yangdaniu8-ui/timing-sentinel-a7/report/llm_collaboration.md

# 大模型协作与技能提炼记录

## 真实性与范围

本文件区分可见对话的逐字节选和工程过程摘要，不补造模型回答或完整聊天导出。去除学校、姓名、账号、凭据和本机私人目录；不公开原会话链接。助手为Codex，具体历史模型子版本没有可靠逐轮记录，不猜测。以下新技能验证为离线操作，不新增实板资格。

## 逐字交互节选：发现漏项并纠正交付判断

**用户提示词：**

> skill准备了吗

**模型回答节选：**

> 有初稿，但还没完成交付，这项确实漏了。

> 刚核查，公开 GitHub 和最终源码 RAR 都没有包含 Skill。

这条回答来自实际目录、跟踪清单和RAR列表核查，不是根据此前385文件哈希通过而推断材料齐全。

**用户进一步要求：**

> Skill 的提交方式与评价标准见 3.3.5.2。从本队作品的开发过程中沉淀即可，但须写清它在本队
> 题目之外还能用在哪类场景，这是官方文档里面的，你仔细查查

**模型复核后的回答节选：**

> 现有初稿还不够，不能只把本项目操作说明改名为 Skill 就算完成。

> 官方没有要求必须安装到 Codex，也没有强制必须采用 `SKILL.md` 格式。

原指南第3.3.3.1、3.3.5.2、3.3.5.3分别约束随作品提交、可复用性与报告说明。复核还明确：通用PYNQ是另行加分，不应为此改变本项目器件；大模型协作与技能包共同15分，不是Skill独占15分。

**用户执行指令：**

> 好的，请你按照文档的详细要求，准备一下

**模型开始执行时的回答节选：**

> 我会按官方条款补齐可复用技能包、题目外示例和验证结果，并整理真实的大模型协作与纠错记录。

## 自我纠错链与人工判断

此前项目草稿绑定旧脚本及本机资料上下文，公开交付白名单没有技能目录。用户指出官方要求后，助手实际重读原文，纠正“有草稿即可交付”的判断：把专用协议和引脚留在案例，把通用检查改为显式文件列表及CSV接口；新增题目外正反例并验证，不把安装到助手当成比赛提交条件。代码包完整性检查仍保留，但补上独立的官方提交项矩阵。

本次第一次文件补丁因同一个README同时使用删除/新增操作而被工具拒绝，未执行任何部分文件写入；随后改成原位更新，保留旧项目专用草稿。这是编辑工具使用错误，不冒充硬件或验证失败。

新增链接拒绝测试两次在Windows失败：模拟按未归一化临时路径匹配，而校验器已resolve为长路径，导致模拟没有命中。第一次只改实际路径类型仍失败；再按规范化路径匹配后重跑，原失败日志保留。另一个真实链接创建测试因Windows权限不足显式skip，使用模拟验证拒绝分支但不声称真实链接用例已执行。技能格式检查器缺少PyYAML，临时依赖仅安装到检查目录，不修改应用环境，也不把依赖错误写成技能通过。

## 开发观察摘要（不是逐字模型原文）

| 真实过程 | 对模型建议的约束与纠正 | 沉淀内容 |
| --- | --- | --- |
| 资源优化候选仿真通过但实现出现BRAM相关DRC，被门禁拒绝 | 不仅追LUT，不从仿真通过推断可上板 | 分层验证与候选身份封存 |
| 串口上传失败后板端记录仍冻结，重连恢复同一记录 | 不把传输故障当采集失败，不盲目重刷 | 状态/身份核查及先保存后释放 |
| 原始记录已保存，旧程序包与新文档未总是同版 | 名称相同不能替代源码与附件核对 | 选定文件的SHA256清单 |
| 同事务四规则新增预设没有蜂鸣，原预设声光正常 | 识别正式RTL白名单限制，改为“仅波形”说明，不为收尾扩展固件 | 把已验证行为与预期区分，保留失败观察 |

这些历史摘要对应工程既有验证记录与当前公开`docs/verification.md`，不作为新脚本的测试次数。原声光问题没有改写成新增预设声光通过。

## 技能如何验证及如何复用

技能入口为`skill/README.md`，脚本使用Python标准库；计数器与四抽头全1系数FIR为两组明确合成夹具。测试检查同值不同CSV顺序仍通过、错值/缺失/篡改正确拒绝，且在仅复制脚本及计数器数据的新目录隔离运行。最终命令、环境、计数及输出哈希见`skill/fpga-evidence-check/validation_result.json`。

题目外可以用于其他RTL黄金结果比对、MCU/FPGA/PC联合交付。输出完整性和数字一致结论，不证明参考算法、综合、时序或实物正确；不宣称跨板实测或PYNQ通用Skill加分。此边界是防止把模型给出的“适用场景”误写为“已验证结果”。

## 工作流与人机分工

助手读取官方要求、提出候选方法、编写脚本与负例、执行离线测试、整理证据；用户确定项目用途、器件条件、硬件接线及外部提交。脚本输出与实际文件优先于模型文字判断。编程、清除记录和外部发布不因读入Skill而自动获得授权。协作记录不是安全凭据、私人聊天或全部工程文件的无差别公开。
