yangdaniu8-ui/timing-sentinel-a7/docs/skill_submission.md

# 技能包与协作材料入口

按本队采用的官方选题指南3.3.3.1、3.3.5.2和3.3.5.3准备。

| 要求 | 交付入口 | 核验范围 |
| --- | --- | --- |
| 技能目录和README | skill/README.md | 适用范围、方法、失效条件、题目外用途 |
| 可直接复用的脚本/工作流 | skill/fpga-evidence-check/ | Python标准库；不绑定原电脑或设备 |
| 已验证效果 | skill/fpga-evidence-check/validation_result.json | 34检查：33通过、1权限skip；两个夹具和隔离目录通过 |
| 失败/观察来源 | skill/fpga-evidence-check/references/origins.md | 工程观察与新脚本验证分开，不删除失败历史 |
| 大模型协作记录 | report/llm_collaboration.md | 真实提示词与模型回答节选、纠错链；摘要不伪装逐字原文 |
| 报告说明 | docs/technical_report.pdf第13页 | 技能提炼、题目外复用、验证与边界；第14页仅参考文献 |
| 许可 | skill/LICENSE | 新技能自有内容MIT许可，非全工程换许可 |

陌生队伍先从skill/README.md执行计数器/FIR对比和测试，再选择自己的文件与CSV输入。技能可独立离线使用，无需改固件或接板。FIR与计数器样本是合成数据，不是新实物资格；新目录迁移不是跨电脑或跨板实测。

与旧包的区别：新增上述技能和协作材料，报告增加一页，应用及两板参考镜像不变。已发布免安装ZIP不因源码仓库更新而自动变动；它内附早期报告，最新报告另从本仓库获取。旧源码RAR同样不会被原地更新，提交时选择含Skill的新包。

本文只是上述条款对应说明，不代表视频、授权书、官网上传等所有赛事条件均已完成，也不保证评委分数。
