yangdaniu8-ui/timing-sentinel-a7/skill/fpga-evidence-check/references/origins.md

# 从真实观察到可复用方法

以下为工程记录摘要，不冒充历史聊天逐字原文。完整性和数值通过不等于硬件资格；历史证据与本次新脚本测试分开。

| 来源观察/失败 | 当时获得的结论 | 本技能采取的动作 | 适用边界 |
| --- | --- | --- | --- |
| 协议缓存优化候选的仿真通过，但另一候选实现出现BRAM相关DRC并被拒绝 | 不能只凭仿真或生成文件接收一个新版本 | 分开源码完整性、数值比对、实现和上板资格 | checker不解析DRC报告，也不证明其结论 |
| 串口长测中断后仍能恢复同一冻结记录 | 传输失败不等于板端捕获失败 | 先保存/核对身份和原始数据，再授权释放；失败报告保留 | 设备需有状态/保存能力，不能套固定寄存器 |
| GPIO和SPI能收到，但UART输入没有跳变 | 需要按信号链定位，而非盲刷两板 | 将采集、传输、接线和任务固件分层排查 | 这是排查次序，不是所有故障的唯一根因 |
| 旧运行包、报告和新源码版本不同步 | 相同标题不代表同一交付输入 | 选定文件清单、字节数和SHA256，并保留旧清单 | 同时被篡改的清单和数据无法靠自校验发现 |
| 按385个既定文件校验通过，却没有把Skill放入源码包 | 白名单完整性不等于官方要求完备 | check明确声明不检查未列文件；发布还需需求矩阵 | 不通过扩大哈希的结论掩盖漏项 |

原工程来源可追溯到随工程提供的`report/llm_collaboration.md`与历史验证概述`docs/verification.md`。本目录可独立使用，不要求读者拥有开发者电脑路径或历史聊天。

提炼过程：先确定上述错误结论的边界，再抽出与项目协议无关的文件/CSV接口，编写失败优先的正反例，最后在仅复制脚本与计数器夹具的新目录中用隔离Python运行。新增脚本是本次提炼产物，不把旧板上600任务称为该脚本的600次验证。
