yangdaniu8-ui/timing-sentinel-a7/skill/fpga-evidence-check/references/triage.md

# 采集故障分层与冻结记录保护

这是来自本队经验的排查清单，不是自动串口控制程序。适用于具有状态、记录身份和缓存读取接口的FPGA/MCU采集设备。无这些接口时先适配，不能猜测命令。设备引脚、电压、端口和身份由新题目确定，不硬编码本队接线。

| 触发条件 | 安全检查步骤 | 停止/失效条件 |
| --- | --- | --- |
| 串口无法连接 | 确认真实端口、线缆枚举和是否被其他程序占用；仅一个串口owner | 不擅自卸驱动、关闭无关程序或刷固件 |
| 已捕获但读到部分数据/掉线 | 保留部分文件和失败报告，重连后先核对session/config，再读同一冻结记录 | 身份改变、状态未知或无法核对时，不能拼接成完整记录 |
| 单一路无跳变但其他路有效 | 检查源端任务/电平、对应信号路径、连接和输入通道配置 | 仅凭一条现象不能宣称接触不良是唯一根因 |
| 希望重新实验/写入镜像 | 先确认重要记录保存完整，再取得释放/编程授权 | 读回或完整性失败时停，不RESET清除证据 |

清单的有效性来自本队上述观察的复盘，并非本次在其他设备上重演过掉线。对其他设备可复用的是分层方法与保护条件，命令和硬件资格不能照搬。
