yangdaniu8-ui/timing-sentinel-a7/references/submission_20261020/photos/fpga_back.jpg

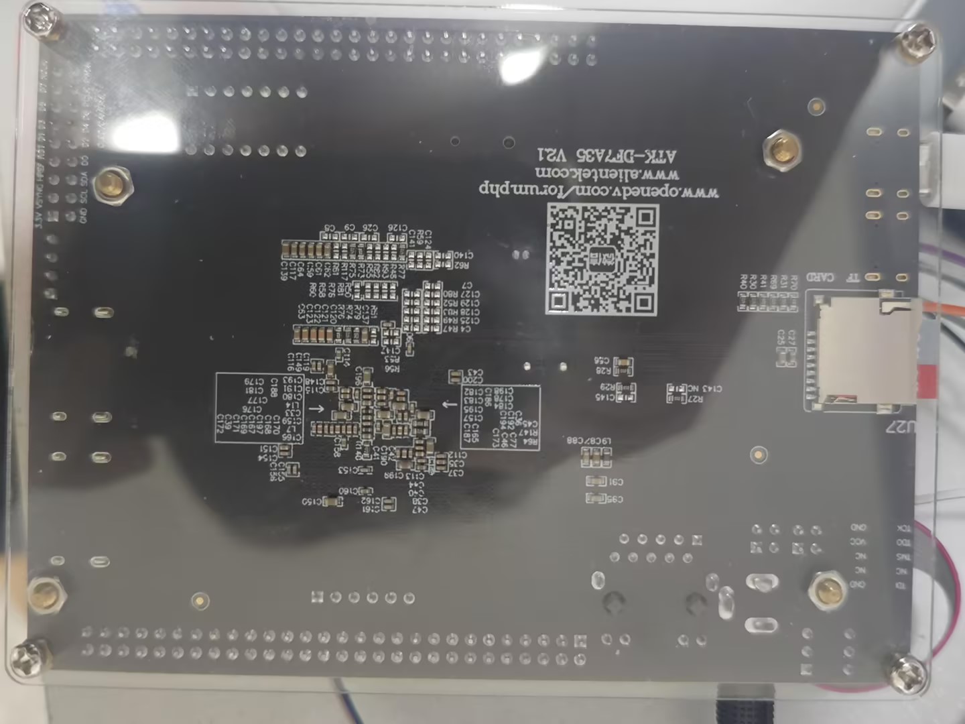
references/submission_20261020/photos/fpga_back.jpg
