yangdaniu8-ui/timing-sentinel-a7/report/assets_20261017/host_workflow.png

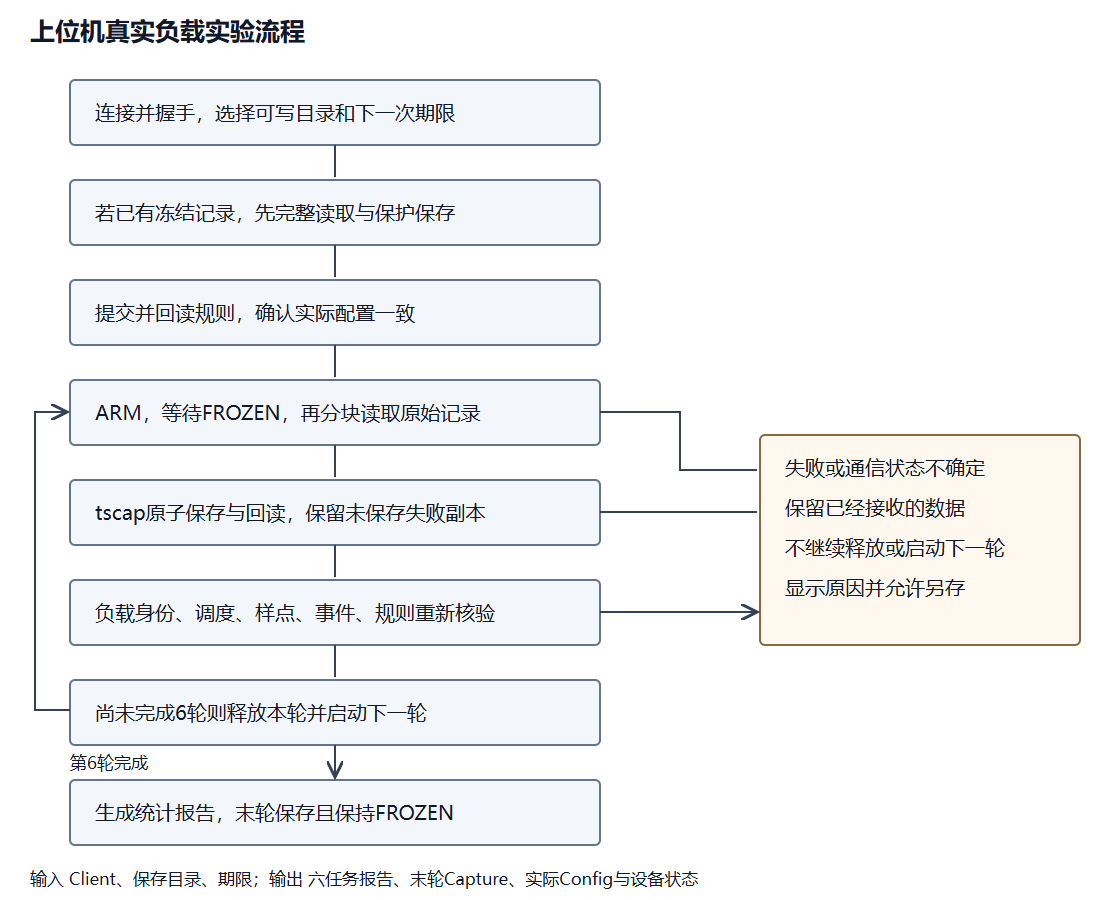
report/assets_20261017/host_workflow.png
