yangdaniu8-ui/timing-sentinel-a7/report/assets_20261017/signal_connections.png

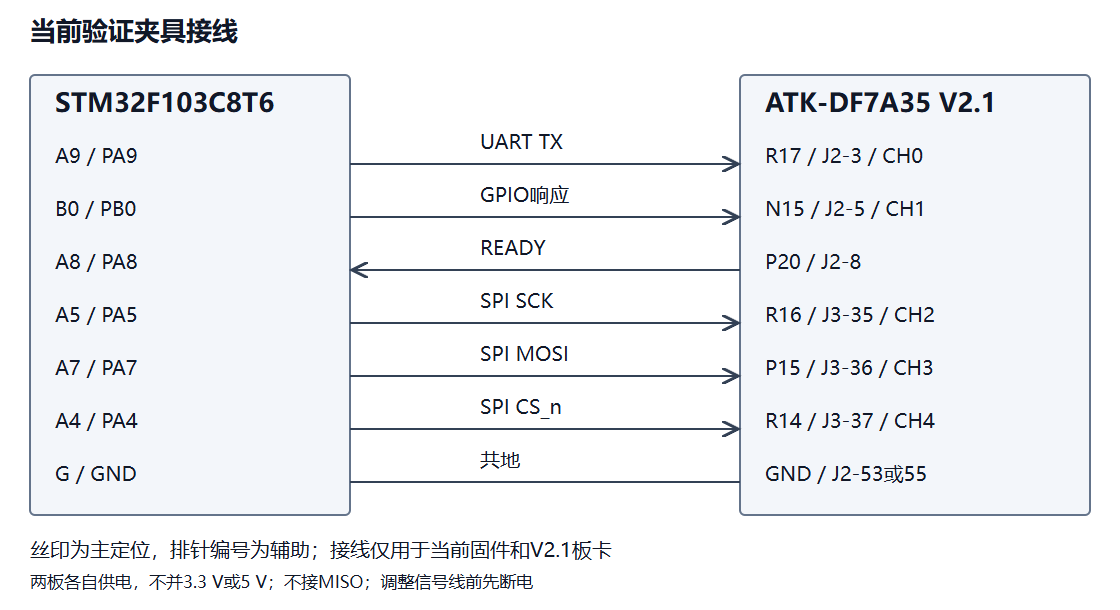
report/assets_20261017/signal_connections.png
