yangdaniu8-ui/timing-sentinel-a7/report/assets_20261020/late_response_public.png

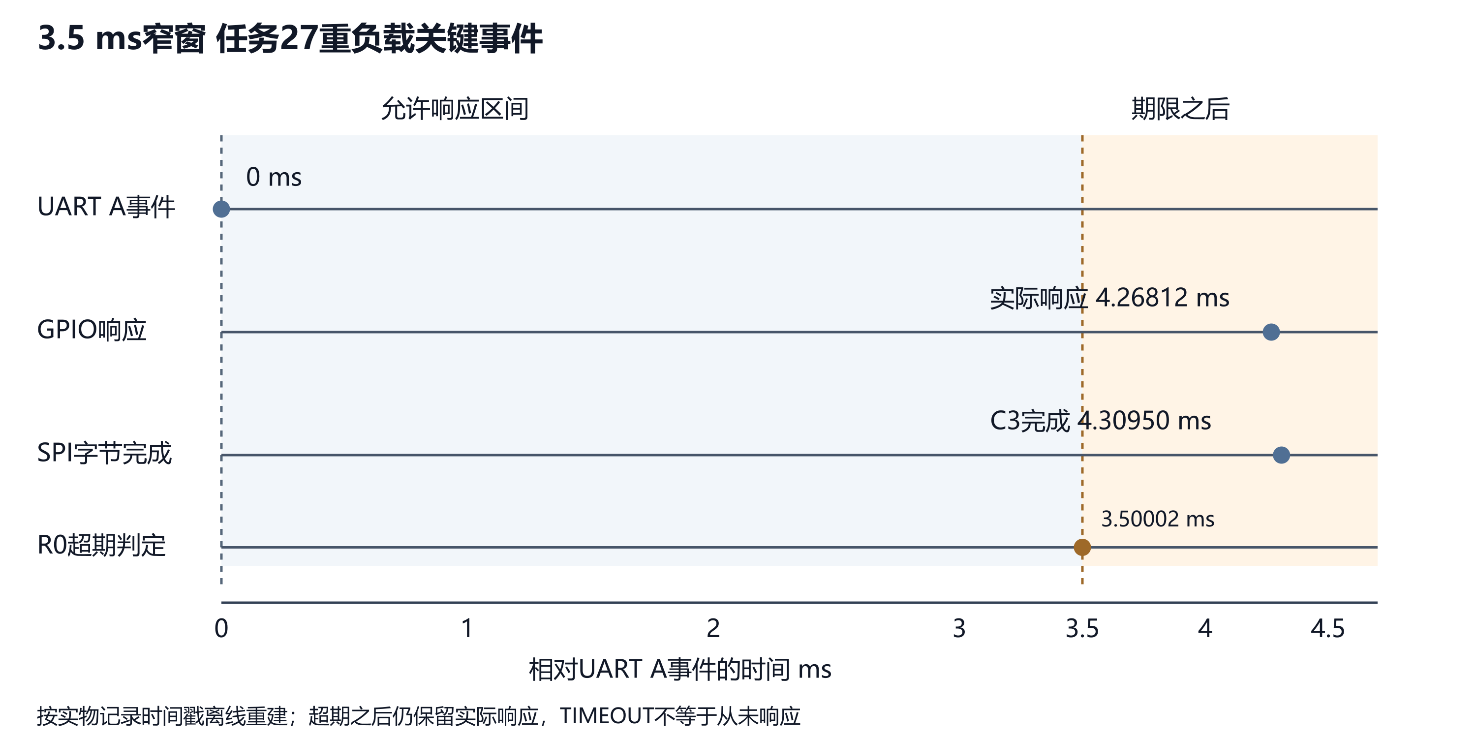
report/assets_20261020/late_response_public.png
