yangdaniu8-ui/timing-sentinel-a7/report/assets_20261020/spi_detail_public_replay.png

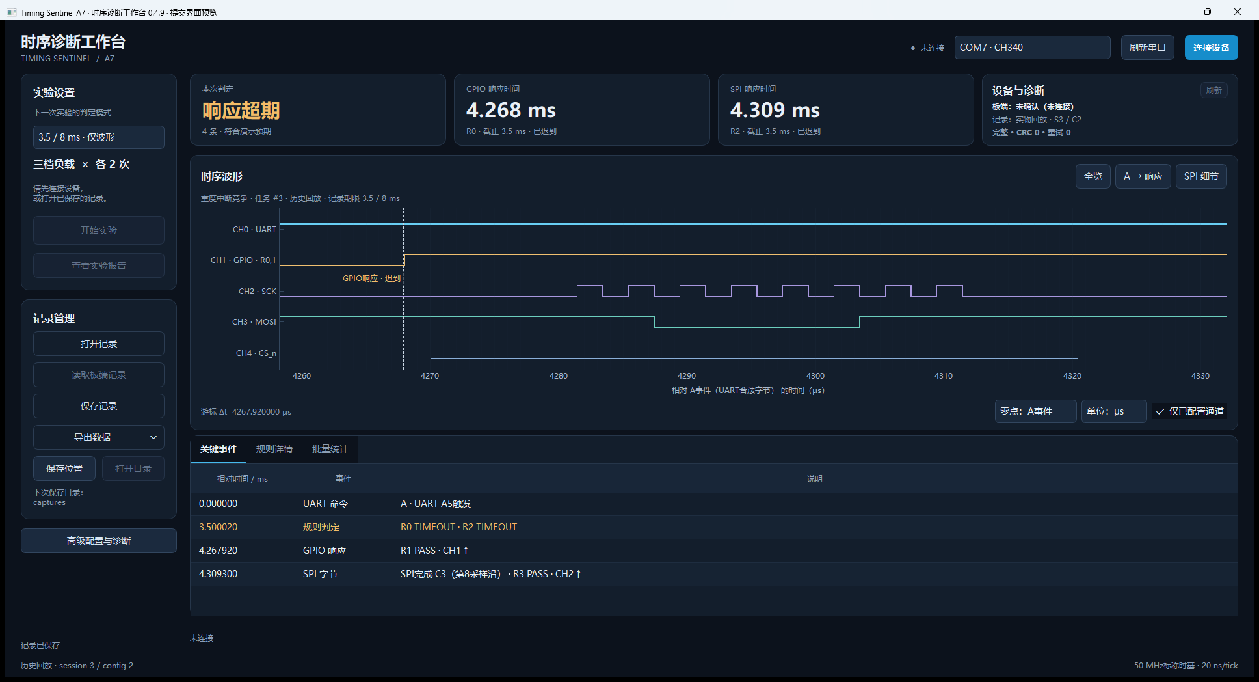
report/assets_20261020/spi_detail_public_replay.png
