yangdaniu8-ui/timing-sentinel-a7/fpga/Sources/Constraints/atk_df7a35_uart.xdc

# Verified against the official DaVinci_FPGA_IO.xdc for ATK-DF7A35 V2.1.
create_clock -period 20.000 -name sys_clk [get_ports sys_clk]
set_property -dict {PACKAGE_PIN R4 IOSTANDARD LVCMOS33} [get_ports sys_clk]
set_property -dict {PACKAGE_PIN U2 IOSTANDARD LVCMOS33} [get_ports sys_rst_n]
set_property -dict {PACKAGE_PIN U5 IOSTANDARD LVCMOS33} [get_ports uart_rxd]
set_property -dict {PACKAGE_PIN T6 IOSTANDARD LVCMOS33 SLEW SLOW DRIVE 8} [get_ports uart_txd]
set_property -dict {PACKAGE_PIN R2 IOSTANDARD LVCMOS33} [get_ports {led[0]}]
set_property -dict {PACKAGE_PIN R3 IOSTANDARD LVCMOS33} [get_ports {led[1]}]
set_property -dict {PACKAGE_PIN V2 IOSTANDARD LVCMOS33} [get_ports {led[2]}]
set_property -dict {PACKAGE_PIN Y2 IOSTANDARD LVCMOS33} [get_ports {led[3]}]
# Asynchronous input/reset terminate at dedicated synchronizer chains.
# Inter-register synchronizer and UART logic paths remain timed at 50 MHz.
set_false_path -from [get_ports uart_rxd]
set_false_path -from [get_ports sys_rst_n]
# UART and LED outputs have no external synchronous capture clock.
set_property CFGBVS VCCO [current_design]
set_property CONFIG_VOLTAGE 3.3 [current_design]
