yangdaniu8-ui/timing-sentinel-a7/host/mvp5/tests/test_safety_mode.py

"""GUI safety boundaries only: no serial, ARM, release or firmware writes."""
import copy
from pathlib import Path
from tempfile import TemporaryDirectory
import unittest
from unittest.mock import Mock,patch
from PySide6.QtWidgets import QApplication,QFileDialog,QMessageBox
from mvp5.store import load_record,save_record,digest

FIXTURES=(Path(__file__).resolve().parents[3] / 'fixtures/usr43')

class SafetyModeTests(unittest.TestCase):
    @classmethod
    def setUpClass(cls):cls.app=QApplication.instance() or QApplication([])
    def setUp(self):
        from mvp5.ui import MainWindow
        self.temp=TemporaryDirectory()
        self.port=patch('mvp5.ui.SerialTransport',side_effect=AssertionError('Unexpected serial open'))
        self.port.start();self.w=MainWindow(root=self.temp.name);self.w.timer.stop()
    def tearDown(self):
        self.w.capture=self.w.client=None;self.w.busy=False;self.w.close();self.w.deleteLater()
        self.app.processEvents();self.port.stop();self.temp.cleanup()
    def consent(self,answer=QMessageBox.StandardButton.Yes):
        with patch.object(QMessageBox,'question',return_value=answer) as prompt:
            self.w.legacy_mode.setChecked(True)
        return prompt
    def idle(self):
        self.w.client=Mock(uncertain=False,session_id=1,config_id=1)
        self.w.device_state='IDLE';self.w.gate()
    def live_capture(self):
        cap=load_record(next(FIXTURES.glob('wide_load2_*')))
        self.w.saved=False;self.w.replay=False;self.w.show_capture(cap);return cap

    def test_unknown_device_idle_does_not_enable_or_show_legacy(self):
        self.idle()
        self.assertFalse(self.w.legacy_debug_enabled)
        self.assertFalse(self.w.buttons['batch'].isEnabled())
        self.assertTrue(self.w.buttons['batch'].isHidden())
        self.assertTrue(self.w.workload_run.isEnabled())
    def test_declining_confirmation_does_not_enter_legacy(self):
        self.consent(QMessageBox.StandardButton.No)
        self.assertFalse(self.w.legacy_mode.isChecked());self.assertFalse(self.w.legacy_debug_enabled)
        self.assertTrue(self.w.buttons['batch'].isHidden())
    def test_confirmation_defaults_to_no_and_warns_no_firmware_identity(self):
        prompt=self.consent()
        self.assertEqual(prompt.call_args.args[-1],QMessageBox.StandardButton.No)
        self.assertIn('不代表固件身份已验证',prompt.call_args.args[2])
    def test_explicit_confirmation_only_changes_gui_state(self):
        self.w.start=Mock();self.consent()
        self.assertTrue(self.w.legacy_debug_enabled);self.assertFalse(self.w.buttons['batch'].isHidden())
        self.assertIsNone(self.w.client);self.w.start.assert_not_called()
    def test_legacy_mode_enables_old_button_only_when_idle(self):
        self.consent();self.idle();self.assertTrue(self.w.buttons['batch'].isEnabled())
        for state in ('FROZEN','ARMED','PREFILL','POST_TRIGGER','UNKNOWN'):
            self.w.device_state=state;self.w.gate();self.assertFalse(self.w.buttons['batch'].isEnabled())
    def test_legacy_mode_blocks_real_task_button_and_direct_slot(self):
        self.consent();self.idle();self.w.start=Mock()
        self.assertFalse(self.w.workload_run.isEnabled())
        with patch.object(QMessageBox,'warning'):self.w.workload_batch()
        self.w.start.assert_not_called()
    def test_exit_legacy_restores_normal_mode(self):
        self.consent();self.w.legacy_mode.setChecked(False);self.idle()
        self.assertTrue(self.w.workload_run.isEnabled());self.assertTrue(self.w.buttons['batch'].isHidden())
    def test_direct_legacy_slot_without_opt_in_cannot_start_worker(self):
        self.idle();self.w.start=Mock()
        with patch.object(QMessageBox,'warning'):self.w.batch()
        self.w.start.assert_not_called()
    def test_legacy_direct_slot_requires_a_connected_idle_device(self):
        self.consent();self.w.start=Mock();self.w.batch();self.w.start.assert_not_called()
        self.idle();self.w.device_state='FROZEN';self.w.batch();self.w.start.assert_not_called()
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
