yangdaniu8-ui/timing-sentinel-a7/(commit log)

2026-10-21 Add reusable evidence skill, verified examples and collaboration records
    [counter_actual.csv, counter_expected.csv, fir_actual.csv, fir_bad.csv, fir_expected.csv]
2026-10-21 Publish reproducible USR43 evidence and license self-owned source under MIT
    [capture.csv]
